SiwaNetwork/QuantumStick/README.md

# TimeStick 2

rev.2.1.1
- изготавливалась
- не завелся ethernet
- неправильные dip свичи

rev.2.1.2
- изменен RJ-45 разъем для прямой трассировки
- dip свич вынесен на край платы

rev.2.1.3
- добавлен отдельный трансформатор на ethernet
