SiwaNetwork/QuantumStick/TimeStick/ECAD/02_PTP_USB_TO_RJ45_DRC/Project Outputs for 02_PTP_USB_TO_RJ45_DRC/Report Board Stack/PCB1.xls

Board Stack Report
Stack Up |  | Layer Stack
Layer | Board Layer Stack | Name | Material | Thickness | Constant | Dk | Df
1 |  | Top Overlay |  | 0mil
2 |  | Top Solder | SM-001 | 1mil | 4 | 4 | 0.03
3 |  | Top Surface Finish | PbSn | 0.787mil
4 |  | Top Layer | CF-004 | 1.378mil
5 |  | Dielectric 1 | PP-017 | 8.284mil | 4.4 | 4.4 | 0.02
6 |  | Int1 (GND) | CF-004 | 0.598mil
7 |  | Dielectric 3 | Core-039 | 41.929mil | 4.6 | 4.6 | 0.02
8 |  | Int2 (PWR) | CF-004 | 0.598mil
9 |  | Dielectric 5 | PP-017 | 8.284mil | 4.4 | 4.4 | 0.02
10 |  | Bottom Layer | CF-004 | 1.378mil
11 |  | Bottom Surface Finish | PbSn | 0.787mil
12 |  | Bottom Solder | SM-001 | 1mil | 4 | 4 | 0.03
13 |  | Bottom Overlay |  | 0mil
 | Height : 66.024mil
