SiwaNetwork/QuantumStick/web_monitor/README.md

# QuantumStick Web Monitor

Современный веб-интерфейс для мониторинга устройства QuantumStick (TimeStick) в реальном времени.






## ✨ Особенности

- 🚀 **Современный интерфейс** - Адаптивный дизайн с темной темой
- 📊 **Графики в реальном времени** - Мониторинг PTP смещения и сетевого трафика
- 🔄 **WebSocket соединение** - Обновления данных без перезагрузки страницы
- 📱 **Мобильная поддержка** - Работает на всех устройствах
- 🎯 **Система алертов** - Уведомления о критических событиях
- 📈 **Детальная статистика** - Информация об устройстве, сети, PTP и системе
- 🛠 **Автоматическое обнаружение** - Поиск устройств TimeStick в системе

## 📋 Требования

### Системные требования
- Linux kernel 3.0+
- Python 3.8 или новее
- Права на чтение сетевых интерфейсов
- Установленные утилиты: `ethtool`, `ip`, `lsusb`

### Python зависимости
- Flask 2.3+
- Flask-SocketIO 5.3+
- python-socketio 5.8+
- eventlet 0.33+

## 🚀 Быстрый старт

### 1. Клонирование репозитория
```bash
git clone <repository-url>
cd QuantumStick/web_monitor
```

### 2. Автоматическая установка и запуск
```bash
chmod +x start_monitor.sh
./start_monitor.sh
```

### 3. Открыть веб-интерфейс
Откройте браузер и перейдите по адресу: http://localhost:8080

## 📖 Подробная установка

### Шаг 1: Установка системных зависимостей

#### Ubuntu/Debian:
```bash
sudo apt update
sudo apt install python3 python3-pip python3-venv ethtool iproute2 usbutils
```

#### CentOS/RHEL:
```bash
sudo yum install python3 python3-pip ethtool iproute usbutils
# или для новых версий:
sudo dnf install python3 python3-pip ethtool iproute usbutils
```

#### Arch Linux:
```bash
sudo pacman -S python python-pip ethtool iproute2 usbutils
```

### Шаг 2: Настройка окружения
```bash
# Создание виртуального окружения
python3 -m venv venv
source venv/bin/activate

# Установка Python зависимостей
pip install --upgrade pip
pip install -r requirements.txt
```

### Шаг 3: Проверка системы
```bash
# Проверка системных требований
./start_monitor.sh --check-only

# Поиск устройств TimeStick
lsusb | grep -i asix
```

## 🎮 Использование

### Запуск мониторинга

#### Автоматический запуск (рекомендуется):
```bash
./start_monitor.sh
```

#### Ручной запуск:
```bash
source venv/bin/activate
python3 app.py
```

#### Опции запуска:
```bash
./start_monitor.sh --help           # Показать справку
./start_monitor.sh --setup-only     # Только настройка окружения
./start_monitor.sh --check-only     # Только проверка системы
./start_monitor.sh --no-check       # Пропустить проверки
```

### Веб-интерфейс

После запуска откройте браузер и перейдите по адресу:
- **Локальный доступ**: http://localhost:8080
- **Сетевой доступ**: http://your-server-ip:8080

#### Основные функции:
1. **Запуск мониторинга** - Нажмите кнопку "Запустить мониторинг"
2. **Просмотр данных** - Данные обновляются автоматически каждую секунду
3. **Переключение графиков** - Выберите "PTP Смещение" или "Сетевой трафик"
4. **Просмотр алертов** - Уведомления отображаются в нижней части
5. **Остановка мониторинга** - Нажмите "Остановить мониторинг"

## 📊 Интерфейс и функции

### Карточки мониторинга

#### 🔧 Информация об устройстве
- Сетевой интерфейс
- Драйвер устройства
- Версия прошивки
- Скорость соединения
- Статус подключения

#### 🌐 Сетевая статистика
- Принятые/переданные пакеты
- Принятые/переданные байты
- Ошибки передачи
- Скорость передачи данных

#### ⏰ PTP Синхронизация
- Статус PTP
- Текущее смещение
- Счетчик синхронизации
- Время последней синхронизации
- Частотная коррекция

#### 💻 Системная информация
- Загрузка CPU (с прогресс-баром)
- Использование памяти (с прогресс-баром)
- Время работы системы
- Температура процессора

### 📈 Графики в реальном времени

#### PTP Смещение
- График смещения времени PTP в наносекундах
- Цветовая индикация: зеленый (хорошо), желтый (предупреждение), красный (ошибка)
- История последних 100 измерений

#### Сетевой трафик
- График пропускной способности в Mbps
- Суммарный RX + TX трафик
- Плавные анимации обновления

### 🚨 Система алертов

#### Типы уведомлений:
- **Ошибки** (красные): Критические проблемы, требующие внимания
- **Предупреждения** (желтые): Потенциальные проблемы
- **Информация** (зеленые): Нормальная работа системы

#### Условия алертов:
- Отключение устройства
- Большое PTP смещение (>10 мкс)
- Сетевые ошибки
- Высокая загрузка системы

## 🔧 Конфигурация

### Настройка портов
По умолчанию веб-сервер запускается на порту 8080. Для изменения отредактируйте файл `app.py`:

```python
if __name__ == '__main__':
    socketio.run(app, host='0.0.0.0', port=8080, debug=False)
```

### Настройка обновлений
Частота обновления данных (по умолчанию 1 секунда) настраивается в методе `monitor_loop()`:

```python
time.sleep(1)  # Обновление каждую секунду
```

### Настройка истории графиков
Количество точек на графиках (по умолчанию 100) настраивается в методе `update_history()`:

```python
max_history = 100  # Последние 100 точек
```

## 🛠 API

### REST Endpoints

#### GET /api/device_data
Получение всех данных устройства в формате JSON.

```json
{
  "device_info": {
    "interface": "eth0",
    "driver": "ax88179_178a",
    "version": "1.2.0",
    "connection_status": "Connected",
    "link_speed": 1000,
    "is_online": true
  },
  "ptp_status": { ... },
  "network_stats": { ... },
  "system_info": { ... },
  "alerts": [ ... ],
  "history": { ... }
}
```

#### POST /api/start_monitoring
Запуск мониторинга устройства.

Ответ:
```json
{
  "status": "success",
  "message": "Мониторинг запущен"
}
```

#### POST /api/stop_monitoring
Остановка мониторинга устройства.

### WebSocket Events

#### Подключение к серверу
```javascript
const socket = io();
```

#### Получение обновлений
```javascript
socket.on('device_update', function(data) {
    // Обработка данных устройства
    console.log(data);
});
```

#### Запрос данных
```javascript
socket.emit('request_data');
```

## 🔍 Диагностика и устранение неполадок

### Проверка устройства
```bash
# Проверка USB устройств ASIX
lsusb | grep -i asix

# Проверка сетевых интерфейсов
ip link show

# Проверка драйверов
for iface in $(ip link show | grep -o 'eth[0-9]*'); do
    echo "Interface: $iface"
    ethtool -i $iface | grep driver
done
```

### Логи и отладка
```bash
# Просмотр логов
tail -f logs/quantum_monitor_*.log

# Запуск с подробными логами
python3 app.py --debug
```

### Частые проблемы

#### Устройство не найдено
- Проверьте подключение USB
- Убедитесь, что драйвер загружен: `lsmod | grep ax88`
- Проверьте права доступа к устройству

#### Ошибки доступа к сети
- Запустите с правами администратора для доступа к ethtool
- Установите недостающие утилиты (ethtool, iproute2)

#### Проблемы с Python зависимостями
```bash
# Переустановка зависимостей
pip install --force-reinstall -r requirements.txt

# Проверка версий
pip list | grep -E "(flask|socketio)"
```

## 📁 Структура проекта

```
web_monitor/
├── app.py                 # Основное приложение Flask
├── start_monitor.sh       # Сценарий запуска
├── requirements.txt       # Python зависимости
├── README.md             # Документация
├── templates/
│   └── index.html        # Веб-интерфейс
├── logs/                 # Директория логов
├── venv/                 # Виртуальное окружение
└── static/               # Статические файлы (если нужны)
```

## 🔒 Безопасность

### Рекомендации
- Не запускайте веб-сервер с правами root в продакшене
- Используйте HTTPS для удаленного доступа
- Настройте firewall для ограничения доступа
- Регулярно обновляйте зависимости

### Настройка HTTPS (опционально)
```python
# В app.py для использования SSL
socketio.run(app, host='0.0.0.0', port=8443, 
             certfile='cert.pem', keyfile='key.pem')
```

## 🤝 Интеграция с существующими инструментами

### Интеграция с chrony
Данные PTP могут быть переданы в chrony для синхронизации времени:

```bash
# Пример конфигурации chrony
refclock PHC /dev/ptp0 poll 0 dpoll -2 offset 0
```

### Экспорт данных
Данные мониторинга можно экспортировать для анализа:

```python
# Сохранение статистики в CSV
import csv
with open('ptp_stats.csv', 'w') as f:
    writer = csv.writer(f)
    writer.writerow(['timestamp', 'offset_ns'])
    # Добавление данных...
```

## 📄 Лицензия

Проект распространяется под лицензией GPL v2, совместимой с основным драйвером TimeStick.

## 👥 Поддержка и вклад

### Сообщение об ошибках
При обнаружении ошибок создайте issue с подробным описанием:
- Версия ОС и ядра Linux
- Версия Python
- Логи ошибки
- Шаги для воспроизведения

### Запросы функций
Для предложения новых функций создайте feature request с описанием:
- Цель и назначение функции
- Примеры использования
- Возможная реализация

## 📞 Контакты

Для получения поддержки и дополнительной информации обращайтесь к документации основного проекта QuantumStick.

---

**QuantumStick Web Monitor** - современное решение для мониторинга высокоточных устройств синхронизации времени.
