SiwaNetwork/QuantumStick/TimeStick/README.md

# 1PPS USB
Это USB-ключ 3.2 Gen1 для гигабитного Ethernet, основанный на чипе AX88179B.
AX88179B поддерживает протокол точного времени (PTP) (IEEE 1588v2 и 802.1AS).
В данной аппаратной реализации используется разъем SMA типа "мама", который предназначен для вывода сигнала 1PPS от AX88179B.
Что это значит:
Ключ обеспечивает высокоскоростное подключение к сети Ethernet, а также включает в себя возможность точной синхронизации времени (с помощью PTP). Но самое главное - он позволяет получить доступ к сигналу 1PPS (Один импульс в секунду), который очень важен для приложений, где требуется точное время, например:
Точный хронометраж: для точного измерения и записи времени.
Научное оборудование: для точной синхронизации научных приборов.
Сети: для точной временной маркировки сетевых пакетов.
Вывод сигнала 1PPS:
Разъем SMA, включенный в этот USB-ключ, позволяет легко и удобно использовать сигнал 1PPS в различных проектах и системах, что делает его ценным инструментом для разработчиков и инженеров, работающих с приложениями, требующими точной синхронизации времени.
