SiwaNetwork/QuantumStick/REMOVAL_SUMMARY.md

# Удаление поддержки Windows - Сводка изменений

## Обзор
Полностью удалена вся поддержка Windows из проекта TimeStick. Теперь проект поддерживает только Linux платформу.

## Удаленные файлы и директории

### Windows Driver
- `windows_driver/` - Полностью удален весь каталог с драйвером для Windows
  - `windows_driver/src/timestick_windows.h` - Заголовочный файл API
  - `windows_driver/src/timestick_driver.c` - Основной код драйвера ядра  
  - `windows_driver/src/timestick_usermode.c` - Пользовательская библиотека
  - `windows_driver/inf/timestick.inf` - INF файл для установки драйвера
  - `windows_driver/build/Makefile` - Система сборки Windows
  - `windows_driver/install_timestick.ps1` - PowerShell скрипт установки
  - `windows_driver/README_WINDOWS.md` - Документация Windows драйвера

### Web Monitor
- `web_monitor/windows_support.py` - Модуль поддержки Windows (19,371 строк)

### Документация
- `WINDOWS_IMPLEMENTATION.md` - Полная документация реализации Windows (244 строки)

## Измененные файлы

### web_monitor/app.py
- Удалены импорты: `from windows_support import ...`
- Удалена переменная `WINDOWS_SUPPORT`
- Упрощена функция `create_monitor()` - только Linux поддержка
- Обновлены API endpoints:
  - `/api/platform` - удален флаг windows_support
  - `/api/devices/detect` - только Linux логика
  - `/api/network/interfaces` - только Linux логика  
  - `/api/driver/install` - возвращает ошибку "не поддерживается на Linux"

### web_monitor/templates/index.html
- Удален раздел "Windows поддержка" из UI
- Удалены кнопки "Поиск устройств" и "Установить драйвер"
- Удалены JavaScript функции:
  - `detectDevices()`
  - `showDriverInstall()`
  - `installDriver(packagePath)`
- Упрощена функция `loadPlatformInfo()`

### web_monitor/requirements.txt
- Удалены Windows-специфичные пакеты:
  - `pywin32==306; sys_platform == "win32"`
  - `wmi==1.5.1; sys_platform == "win32"`

## Удаленные Git ветки
- `cursor/windows-c4d5` - локальная ветка разработки Windows

## Статистика изменений
- **12 файлов изменено**
- **33 добавления, 2402 удаления**
- **Удалено ~20,000 строк Windows-специфичного кода**

## Результат
Проект теперь поддерживает **только Linux** платформу. Весь Windows-специфичный код, драйверы, документация и зависимости полностью удалены. Система стала значительно проще и сфокусирована на Linux окружении.
