SiwaNetwork/QuantumStick/QUANTUM_STICK_WEB_MONITOR.md

# QuantumStick Web Monitor - Обзор проекта

## 🎯 Что было создано

Я разработал современный веб-интерфейс для мониторинга устройства QuantumStick (TimeStick) с нуля, заменив консольные приложения на C современным веб-решением.

## ✨ Основные улучшения

### 🔄 Переход от консольного к веб-интерфейсу
- **Было**: Консольные программы `timestick_monitor.c` и `timestick_ptp_monitor.c` с ncurses
- **Стало**: Современный адаптивный веб-интерфейс с темной темой

### 📊 Визуализация данных
- **Было**: Текстовый вывод статистики
- **Стало**: Интерактивные графики в реальном времени с Chart.js

### 🔗 Архитектура
- **Было**: Прямая работа с IOCTL и системными вызовами
- **Стало**: Backend Flask + WebSocket для real-time обновлений

## 🏗️ Архитектура решения

```
┌─────────────────────────────────────────────────────────────┐
│                    Веб-браузер                              │
│   ┌─────────────┐  ┌─────────────┐  ┌─────────────┐        │
│   │   График    │  │  Карточки   │  │   Алерты    │        │
│   │     PTP     │  │ мониторинга │  │             │        │
│   └─────────────┘  └─────────────┘  └─────────────┘        │
└─────────────────────┬───────────────────────────────────────┘
                      │ WebSocket / HTTP
┌─────────────────────▼───────────────────────────────────────┐
│                Flask Backend (Python)                      │
│  ┌─────────────────────────────────────────────────────────┐│
│  │           TimeStickMonitor Class                       ││
│  │  • Обнаружение устройств                               ││
│  │  • Чтение данных через ethtool/ip                      ││
│  │  • Мониторинг PTP через /dev/ptp*                      ││
│  │  • Системная статистика                                ││
│  └─────────────────────────────────────────────────────────┘│
└─────────────────────┬───────────────────────────────────────┘
                      │ System calls
┌─────────────────────▼───────────────────────────────────────┐
│                  Linux System                              │
│  • ethtool (информация о драйвере)                         │
│  • /proc/net/dev (сетевая статистика)                      │
│  • /dev/ptp* (PTP устройства)                              │
│  • /proc/loadavg, /proc/meminfo (система)                  │
└─────────────────────────────────────────────────────────────┘
```

## 📂 Структура проекта

```
web_monitor/
├── 📄 app.py                 # Основное Flask приложение
├── 🎭 demo_mode.py           # Демо режим для тестирования
├── 🌐 templates/
│   └── index.html            # Современный веб-интерфейс
├── 🚀 start_monitor.sh       # Автоматический запуск
├── 🔧 Makefile               # Система сборки и управления
├── 📋 requirements.txt       # Python зависимости
├── 📖 README.md              # Полная документация
└── ⚡ QUICK_START.md         # Быстрый старт
```

## 🎨 Интерфейс

### Главный экран
- **Заголовок**: Логотип и индикатор подключения
- **Панель управления**: Кнопки запуска/остановки/обновления
- **Карточки мониторинга**: 4 основные секции
- **Графики**: Переключаемые диаграммы в реальном времени
- **Алерты**: Система уведомлений

### Карточки мониторинга

#### 🔧 Устройство
- Сетевой интерфейс
- Драйвер и версия
- Скорость соединения
- Статус подключения

#### 🌐 Сеть  
- RX/TX пакеты и байты
- Ошибки передачи
- Цветовая индикация проблем

#### ⏰ PTP Синхронизация
- Статус включения
- Текущее смещение
- Счетчик синхронизации
- Время последней синхронизации

#### 💻 Система
- CPU загрузка (с прогресс-баром)
- Память (с прогресс-баром)  
- Время работы
- Температура

### Графики реального времени
- **PTP Смещение**: График отклонений синхронизации
- **Сетевой трафик**: Пропускная способность
- **Переключение**: Вкладки для выбора типа графика
- **История**: Последние 100 измерений

## 🚀 Возможности

### Real-time мониторинг
- ⚡ Обновления каждую секунду
- 🔄 WebSocket соединение
- 📊 Анимированные графики
- 🎯 Автоматические алерты

### Адаптивность
- 📱 Мобильная поддержка
- 🌙 Темная тема
- 🎨 Современный дизайн
- ✨ Плавные анимации

### Система алертов
- 🔴 Критические ошибки
- 🟡 Предупреждения
- 🟢 Информационные сообщения
- 📅 Временные метки

## 🛠️ Установка и использование

### Быстрый старт (демо)
```bash
cd web_monitor
make demo
# Откройте http://localhost:8080
```

### С реальным устройством
```bash
cd web_monitor
make install
make run
# Откройте http://localhost:8080
```

### Системные требования
- Linux kernel 3.0+
- Python 3.8+
- ethtool, iproute2
- Браузер с поддержкой WebSocket

## 🎭 Демо режим

Для тестирования без реального устройства создан полнофункциональный демо режим:

- ✅ Имитация PTP смещений с реалистичными колебаниями
- ✅ Генерация сетевого трафика
- ✅ Системная нагрузка
- ✅ Случайные алерты
- ✅ Полная функциональность UI

## 🔧 Технический стек

### Backend
- **Flask** - веб-фреймворк
- **Flask-SocketIO** - WebSocket поддержка
- **Python 3.8+** - основной язык

### Frontend  
- **HTML5** - семантическая разметка
- **CSS3** - современные стили, анимации
- **JavaScript** - интерактивность
- **Chart.js** - графики
- **Socket.IO** - real-time обновления
- **Font Awesome** - иконки

### Система
- **ethtool** - информация о сетевых интерфейсах
- **iproute2** - управление сетью
- **/proc filesystem** - системная статистика
- **/dev/ptp*** - PTP устройства

## 🆚 Сравнение с оригиналом

| Аспект | Оригинал (C/ncurses) | Новый (Web) |
|---|---|---|
| **Интерфейс** | Консольный текст | Современный веб |
| **Доступность** | Только локально | Удаленный доступ |
| **Графики** | Нет | Интерактивные |
| **Мобильность** | Нет | Адаптивный |
| **Установка** | make/gcc | Python/pip |
| **Расширяемость** | Сложно | Легко |
| **Пользователи** | Один | Множество |

## 🎯 Преимущества

### Для пользователей
- 🌐 **Веб-доступ**: Мониторинг из любой точки сети
- 📱 **Мобильность**: Работа на телефонах и планшетах  
- 👁️ **Наглядность**: Графики вместо цифр
- 🔄 **Real-time**: Автоматические обновления

### Для разработчиков
- 🛠️ **Современность**: Актуальный технологический стек
- 🔧 **Расширяемость**: Простое добавление функций
- 🧪 **Тестирование**: Демо режим
- 📖 **Документация**: Подробные инструкции

### Для администраторов
- 🚀 **Простота**: Автоматическая установка
- 📊 **Мониторинг**: Централизованный контроль
- 🔍 **Диагностика**: Детальные логи
- 🎯 **Алерты**: Уведомления о проблемах

## 🚀 Возможности расширения

### Дополнительные функции
- 📈 **Экспорт данных** в CSV/JSON
- 📧 **Email уведомления** при критических событиях
- 🔐 **Аутентификация** для безопасного доступа
- 📊 **Дашборды** для множественных устройств
- 🔌 **API расширения** для интеграций

### Интеграции
- **Grafana** - расширенная аналитика
- **Prometheus** - метрики и мониторинг
- **chrony/ntpd** - интеграция с NTP серверами
- **SNMP** - стандартные протоколы мониторинга

## 📈 Результат

Создан современный, наглядный и функциональный веб-интерфейс для мониторинга QuantumStick, который:

✅ **Заменяет** устаревшие консольные программы  
✅ **Обеспечивает** удаленный доступ и мобильность  
✅ **Предоставляет** визуализацию в реальном времени  
✅ **Упрощает** установку и использование  
✅ **Расширяет** возможности мониторинга  

Система готова к использованию и может быть легко адаптирована под конкретные требования!
