SiwaNetwork/QuantumStick/TimeStick2/Archive/MFG_OUTPUTS/Report Board Stack/PCB1.xls

Board Stack Report
Stack Up |  | Layer Stack
Layer | Board Layer Stack | Name | Material | Thickness | Constant | Dk | Df
1 |  | Top Overlay |  | 0mm
2 |  | Top Solder | SM-001 | 0.0254mm | 4 | 4 | 0.03
3 |  | Top Surface Finish | PbSn | 0.02mm
4 |  | Top Layer | CF-004 | 0.035mm
5 |  | Dielectric 1 | PP-017 | 0.2104mm | 4.4 | 4.4 | 0.02
6 |  | Int1 (GND) | CF-004 | 0.0152mm
7 |  | Dielectric 3 | Core-039 | 1.065mm | 4.6 | 4.6 | 0.02
8 |  | Int2 (PWR) | CF-004 | 0.0152mm
9 |  | Dielectric 5 | PP-017 | 0.2104mm | 4.4 | 4.4 | 0.02
10 |  | Bottom Layer | CF-004 | 0.035mm
11 |  | Bottom Surface Finish | PbSn | 0.02mm
12 |  | Bottom Solder | SM-001 | 0.0254mm | 4 | 4 | 0.03
13 |  | Bottom Overlay |  | 0mm
 | Height : 1.677mm
