SiwaNetwork/QuantumStick/TimeStick2.1.2/ECAD/Project Outputs for TIMESTICK_2.1/TIMESTICK_2.1_rev.1.2_BOM 2025-04-30 12-16.xlsx

Designator | Comment | Description | Footprint | LibRef | Quantity | HelpURL | Value
C1, C2, C3, C4, C8, C9, C11, C12, C17, C20, C23, C24, C25, C26, C27, C28, C29, C31, C32, C33, C34, C36, C37, C38, C39, C41, C42, C43, C44 | 0.1 µF | CAP CER 0.1UF 10V X7R 0402 | CAP 0402_1005 | CC0402KRX7R6BB104 | 29 |  | 0.1 µF
C5 | 10000 pF | CAP CER 10000PF 50V X7R 0402 | CAP 0402_1005 | CC0402KRX7R9BB103 | 1 |  | 10000 pF
C6, C15 | 1000 pF/2kV | CAP CER 1000PF 2KV X7R 1206 | CAP 1206_3216 - 0.8MM | CC1206KKX7RDBB102 | 2 |  | 1000 pF/2kV
C7 | 47 pF | CAP CER 47PF 50V C0G/NPO 0402 | CAP 0402_1005 | CC0402KRNPO9BN470 | 1 |  | 47 pF
C10, C16 | 1 µF | CAP CER 1UF 10V X5R 0402 | CAP 0402_1005 | CC0402KRX5R6BB105 | 2 |  | 1 µF
C13, C14 | 15 pF | CAP CER 15PF 50V C0G/NPO 0402 | CAP 0402_1005 | CC0402KRNPO9BN150 | 2 |  | 15 pF
C18, C30 | 22 µF | CAP CER 22UF 10V X5R 0603 | CAP 0603_1608 | CC0603MRX5R6BB226 | 2 |  | 22 µF
C19, C21, C22, C35, C40 | 4.7 µF | CAP CER 4.7UF 10V X5R 0402 | CAP 0402_1005 | CC0402MRX5R6BB475 | 5 |  | 4.7 µF
D1, D2 | L-1154GT | LED, 3mm, Green | LED_3MM_GREEN | L-1154GT | 2
D3, D4, D5 | TPD2EUSB30 | TVS DIODE 3.6VWM 8VC SOT3 | SOT35P100X50-3N | TPD2EUSB30ADRTR | 3
FB1, FB2, FB3, FB4, FB5 | 80 Ohms @ 100 MHz | FERRITE BEAD 80 OHM 0402 1LN | FER 0402_1005 | BLM15PD800SN1D | 5 |  | 80 Ohms @ 100 MHz
IC1 | NEO-M9N-00B | Integrated Circuit | NEOM9N00B | NEO-M9N-00B | 1
IC2 | MAX-M10M-00B | Integrated Circuit | MAXM10M00B | MAX-M10M-00B | 1
J1, J2, J5 | RF2-49B-T-00-50-G-HDW | Connector | RF249BT0050GHDW | RF2-49B-T-00-50-G-HDW | 3
J3 | PBS-5 | Connector | PBS-5 | PBS-5 | 1
J4 | ARJM11B1-805-AB-EW2 | Connector | ARJM11B1805ABEW2 | ARJM11B1-805-AB-EW2 | 1
J6 | 1054500101 | CONN RCP USB3.1 TYPEC 24P SMD RA | Molex 1054500101 | 1054500101 | 1
L1 | 27 nH | FIXED IND 27NH 350MA 0.46OHM SMD | Murata LQG15 0402 | LQG15HS27NJ02D | 1 |  | 27 nH
L2, L3 | 3.3µH | FIXED IND 3.3UH 1.2A 100 MOHM | IND 1008_2520 | LQM2HPN3R3MG0L | 2 |  | 3.3µH
Q1 | DMG2302UKQ-7 | MOSFET BVDSS: 8V-24V SOT23 T&R 3 | DIODES SOT-23-3 | DMG2302UKQ-7 | 1
R1, R2, R4, R5, R31, R32, R34, R35, R36, R37, R38 | 4.7 kOhms | RES 4.7K OHM 1% 1/16W 0402 | YAGEO RES 0402_1005 | RC0402FR-074k7L | 11 |  | 4.7 kOhms
R6, R7, R19, R40 | 10 kOhms | RES 10K OHM 1% 1/16W 0402 | YAGEO RES 0402_1005 | RC0402FR-0710KL | 4 |  | 10 kOhms
R8, R10 | 330 Ohms | RES 330 OHM 1% 1/16W 0402 | YAGEO RES 0402_1005 | RC0402FR-07330RL | 2 |  | 330 Ohms
R11, R13, R14, R16, R23, R26, R28 | 0 Ohms | RES 0 OHM JUMPER 1/16W 0402 | YAGEO RES 0402_1005 | RC0402FR-070RL | 7 |  | 0 Ohms
R12 | 10 Ohms | RES 10 OHM 1% 1/10W 0603 | YAGEO RES 0603_1608 | RC0603FR-0710RL | 1 |  | 10 Ohms
R15, R33 | 1 MOhms | RES 1M OHM 1% 1/16W 0402 | YAGEO RES 0402_1005 | RC0402FR-071ML | 2 |  | 1 MOhms
R17 | 49.9 kOhms | RES 49.9K OHM 1% 1/16W 0402 | YAGEO RES 0402_1005 | RC0402FR-0749K9L | 1 |  | 49.9 kOhms
R18 | 100 kOhms | RES 100K OHM 1% 1/16W 0402 | YAGEO RES 0402_1005 | RC0402FR-07100KL | 1 |  | 100 kOhms
R21 | 24 kOhms | RES 24K OHM 1% 1/16W 0402 | YAGEO RES 0402_1005 | RC0402FR-0724KL | 1 |  | 24 kOhms
R22, R24, R25 | 47 kOhms | RES 47K OHM 1% 1/16W 0402 | YAGEO RES 0402_1005 | RC0402FR-0747KL | 3 |  | 47 kOhms
R27 | 200 Ohms | RES 200 OHM 1% 1/16W 0402 | YAGEO RES 0402_1005 | RC0402FR-07200RL | 1 |  | 200 Ohms
R29, R30 | 5.1 kOhms | RES 5.1K OHM 1% 1/16W 0402 | YAGEO RES 0402_1005 | RC0402FR-075k1L | 2 |  | 5.1 kOhms
R39 | 22 Ohms | RES 22 OHM 1% 1/16W 0402 | YAGEO RES 0402_1005 | RC0402FR-0722RL | 1 |  | 22 Ohms
R41 | 39.2 kOhms | RES 39.2K OHM 1% 1/16W 0402 | YAGEO RES 0402_1005 | RC0402FR-0739K2L | 1 |  | 39.2 kOhms
S1 | DA-02RP | DIP Switch, 2P | DA02RP | DA-02RP | 1
U1, U3 | NC7WZ125K8X | Integrated Circuit | SOP50P310X90-8N | NC7WZ125K8X | 2
U2, U4 | SN74LVC1G3157DBVR | Integrated Circuit | SOT95P280X145-6N | SN74LVC1G3157DBVR | 2
U5 | AX88279 |  | IC_AX88279 | IC_AX88279 | 1
U6 | ST1S06PU33R | Synchronous rectification with inhibit, 1.5 A, 1.5 MHz adjustable, step-down switching regulator, 6-Pin DFN | DFN6D_L | CMP-0240-00158-1 | 1
U7 | SST25VF016B-50-4I-QAF-T | SST25VF016B-50-4I-QAF-T Flash Serial-SPI 3.3V 16Mbit 2M x 8bit 8ns 8-Pin WSON EP T/R - Tape and Reel | FP-C04-452-MFG | CMP-00252-18686437-1 | 1
U8 | ST1S06PUR | Synchronous rectification with inhibit, 1.5 A, 1.5 MHz adjustable, step-down switching regulator, 6-Pin DFN | DFN6D_M | CMP-0240-00159-1 | 1
Y1 | 25 MHz | CRYSTAL 25.0000MHZ 8PF SMD | NDK NX3225GA | NX3225GA-25.000M-STD-CRG-2 | 1 |  | 25 MHz
