SiwaNetwork/QuantumStick/TimeStick2/ECAD/Project Outputs for TIMESTICK_2/TIMESTICK_2_rev.1.1_release BOM 2025-02-25 10-48.xlsx

Designator | Comment | Description | Footprint | LibRef | Quantity | HelpURL | Value
C1, C2, C3, C4, C5, C6, C7, C8, C10, C11, C17, C19, C23, C24, C25, C26, C27, C28, C30, C31, C32, C33, C36, C37, C38, C39, C40, C41, C42, C43, C44 | 0.1 µF | CAP CER 0.1UF 10V X7R 0402 | CAP 0402_1005 | CC0402KRX7R6BB104 | 31 |  | 0.1 µF
C9, C15 | 1000 pF/2kV | CAP CER 1000PF 2KV X7R 1206 | CAP 1206_3216 - 0.8MM | CC1206KKX7RDBB102 | 2 |  | 1000 pF/2kV
C12 | 47 pF | CAP CER 47PF 50V C0G/NPO 0402 | CAP 0402_1005 | CC0402KRNPO9BN470 | 1 |  | 47 pF
C13, C14 | 15 pF | CAP CER 15PF 50V C0G/NPO 0402 | CAP 0402_1005 | CC0402KRNPO9BN150 | 2 |  | 15 pF
C16 | 1 µF | CAP CER 1UF 10V X5R 0402 | CAP 0402_1005 | CC0402KRX5R6BB105 | 1 |  | 1 µF
C18, C34 | 22 µF | CAP CER 22UF 10V X5R 0603 | CAP 0603_1608 | CC0603MRX5R6BB226 | 2 |  | 22 µF
C20, C21, C22, C29, C35 | 4.7 µF | CAP CER 4.7UF 10V X5R 0402 | CAP 0402_1005 | CC0402MRX5R6BB475 | 5 |  | 4.7 µF
D1, D2 | APT1608ZGCK | LED GREEN CLEAR CHIP SMD | FP-APT1608ZGCK-MFG | CMP-44529-000024-1 | 2
FB1, FB2, FB3, FB4, FB5 | 80 Ohms @ 100 MHz | FERRITE BEAD 80 OHM 0402 1LN | FER 0402_1005 | BLM15PD800SN1D | 5 |  | 80 Ohms @ 100 MHz
IC1 | MAX-F10S-00B | Integrated Circuit | MAXF10S00B | MAX-F10S-00B | 1
J1, J2 | 73100-0114 | Connector | 731000114 | 73100-0114 | 2
J3 | PBS-5 | Connector | PBS-5 | PBS-5 | 1
J4 | ARJM11D7-809-AB-EW2 | Connector | ARJM11D7809ABEW2 | ARJM11D7-809-AB-EW2 | 1
J5 | 1054500101 | CONN RCP USB3.1 TYPEC 24P SMD RA | Molex 1054500101 | 1054500101 | 1
L1, L2 | 3.3µH | FIXED IND 3.3UH 1.2A 100 MOHM | IND 1008_2520 | LQM2HPN3R3MG0L | 2 |  | 3.3µH
R1, R2, R8, R9, R18, R19, R32, R33, R34, R35 | 4.7 kOhms | RES 4.7K OHM 1% 1/16W 0402 | YAGEO RES 0402_1005 | RC0402FR-074k7L | 10 |  | 4.7 kOhms
R3, R4, R5, R6, R16, R37 | 10 kOhms | RES 10K OHM 1% 1/16W 0402 | YAGEO RES 0402_1005 | RC0402FR-0710KL | 6 |  | 10 kOhms
R10, R12 | 330 Ohms | RES 330 OHM 1% 1/16W 0402 | YAGEO RES 0402_1005 | RC0402FR-07330RL | 2 |  | 330 Ohms
R13, R30 | 1 MOhms | RES 1M OHM 1% 1/16W 0402 | YAGEO RES 0402_1005 | RC0402FR-071ML | 2 |  | 1 MOhms
R14 | 49.9 kOhms | RES 49.9K OHM 1% 1/16W 0402 | YAGEO RES 0402_1005 | RC0402FR-0749K9L | 1 |  | 49.9 kOhms
R17 | 100 kOhms | RES 100K OHM 1% 1/16W 0402 | YAGEO RES 0402_1005 | RC0402FR-07100KL | 1 |  | 100 kOhms
R20 | 33 Ohms | RES 33 OHM 1% 1/16W 0402 | YAGEO RES 0402_1005 | RC0402FR-0733RL | 1 |  | 33 Ohms
R21 | 24 kOhms | RES 24K OHM 1% 1/16W 0402 | YAGEO RES 0402_1005 | RC0402FR-0724KL | 1 |  | 24 kOhms
R22, R24, R25 | 47 kOhms | RES 47K OHM 1% 1/16W 0402 | YAGEO RES 0402_1005 | RC0402FR-0747KL | 3 |  | 47 kOhms
R23, R26, R27 | 0 Ohms | RES 0 OHM JUMPER 1/16W 0402 | YAGEO RES 0402_1005 | RC0402FR-070RL | 3 |  | 0 Ohms
R28 | 200 Ohms | RES 200 OHM 1% 1/16W 0402 | YAGEO RES 0402_1005 | RC0402FR-07200RL | 1 |  | 200 Ohms
R29, R31 | 5.1 kOhms | RES 5.1K OHM 1% 1/16W 0402 | YAGEO RES 0402_1005 | RC0402FR-075k1L | 2 |  | 5.1 kOhms
R36 | 22 Ohms | RES 22 OHM 1% 1/16W 0402 | YAGEO RES 0402_1005 | RC0402FR-0722RL | 1 |  | 22 Ohms
R38 | 39.2 kOhms | RES 39.2K OHM 1% 1/16W 0402 | YAGEO RES 0402_1005 | RC0402FR-0739K2L | 1 |  | 39.2 kOhms
SW1 | 218-4LPST | SWITCH SLIDE DIP SPST 25MA 24V | CTS 218-4LPJ | 218-4LPST | 1
U1, U4 | NC7WZ125K8X | Integrated Circuit | SOP50P310X90-8N | NC7WZ125K8X | 2
U2, U3, U5, U6 | SN74LVC1G3157DBVR | Integrated Circuit | SOT95P280X145-6N | SN74LVC1G3157DBVR | 4
U7 | AX88279 |  | IC_AX88279 | IC_AX88279 | 1
U8 | ESD7016MUTAG | Low Capacitance ESD Protection USB 3.0, 8-Pin UDFN, Pb-Free, Tape and Reel | ONSC-UDFN-8-517CB_V | CMP-1063-00263-1 | 1
U9 | ST1S06PU33R | Synchronous rectification with inhibit, 1.5 A, 1.5 MHz adjustable, step-down switching regulator, 6-Pin DFN | DFN6D_L | CMP-0240-00158-1 | 1
U10 | SST25VF016B-50-4I-QAF-T | SST25VF016B-50-4I-QAF-T Flash Serial-SPI 3.3V 16Mbit 2M x 8bit 8ns 8-Pin WSON EP T/R - Tape and Reel | FP-C04-452-MFG | CMP-00252-18686437-1 | 1
U11 | ST1S06PUR | Synchronous rectification with inhibit, 1.5 A, 1.5 MHz adjustable, step-down switching regulator, 6-Pin DFN | DFN6D_M | CMP-0240-00159-1 | 1
Y1 | 25 MHz | CRYSTAL 25.0000MHZ 8PF SMD | NDK NX3225GA | NX3225GA-25.000M-STD-CRG-2 | 1 |  | 25 MHz
