SiwaNetwork/QuantumStick/TimeStick2.1.2/ECAD/TIMESTICK_2.SLDASM

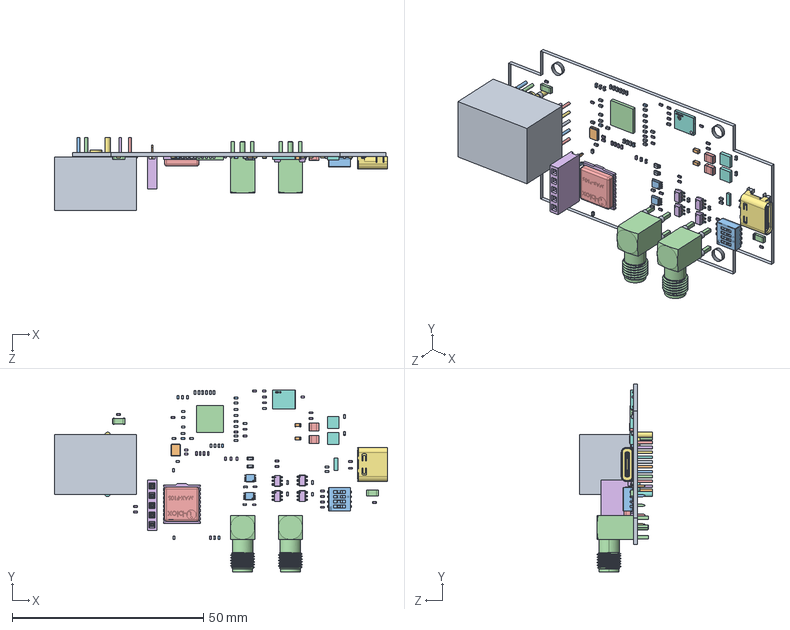
[picture p7: CAD file, 2025-07-18]
TimeStick2.1.2/ECAD/TIMESTICK_2.SLDASM
87.2 x 49.1 x 19.1 mm
0402 cap x 40
0603 cap x 2
FER 0402 x 5
7864657856-Part-2 x 2
INDUC 1008 x 2
0402 resistor x 35
0402 resistor-1 x 35
Extruded x 2
logo x 2
logo-1 x 2
logo-2 x 2
logo-3 x 2
logo-4 x 2
logo-5 x 2
logo-6 x 2
logo-7 x 2
logo-8 x 2
logo-9 x 2
logo-10 x 2
logo-11 x 2
cathode mark x 2
cathode mark-1 x 2
terminals x 2
terminals-1 x 2
lens x 2
base x 2
PinsArrayLR x 2
PinsArrayLR-1 x 2
PinsArrayLR-2 x 2
PinsArrayLR-3 x 2
PinsArrayLR-4 x 2
PinsArrayLR-5 x 2
PinsArrayLR-6 x 2
PinsArrayLR-7 x 2
Extruded-1
microchip
microchip-1
microchip-2
microchip-3
microchip-4
microchip-5
microchip-6
microchip-7
microchip-8
Microchip logo
circle
User Library-PBS_(DS1023)_1line_connectors_h=5_0_8_5mm_step_2_54mm (3)
User Library-PBS_(DS1023)_1line_connectors_h=5_0_8_5mm_step_2_54mm (3)-1
User Library-PBS_(DS1023)_1line_connectors_h=5_0_8_5mm_step_2_54mm (3)-2
User Library-PBS_(DS1023)_1line_connectors_h=5_0_8_5mm_step_2_54mm (3)-3
User Library-PBS_(DS1023)_1line_connectors_h=5_0_8_5mm_step_2_54mm (3)-4
User Library-PBS_(DS1023)_1line_connectors_h=5_0_8_5mm_step_2_54mm (3)-5
PinsArrayLR-8 x 4
PinsArrayLR-9 x 4
PinsArrayLR-10 x 4
PinsArrayLR-11 x 4
PinsArrayLR-12 x 4
PinsArrayLR-13 x 4
Leads
Leads-1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
