SiwaNetwork/QuantumStick/TimeStick/TimeStick.PDF

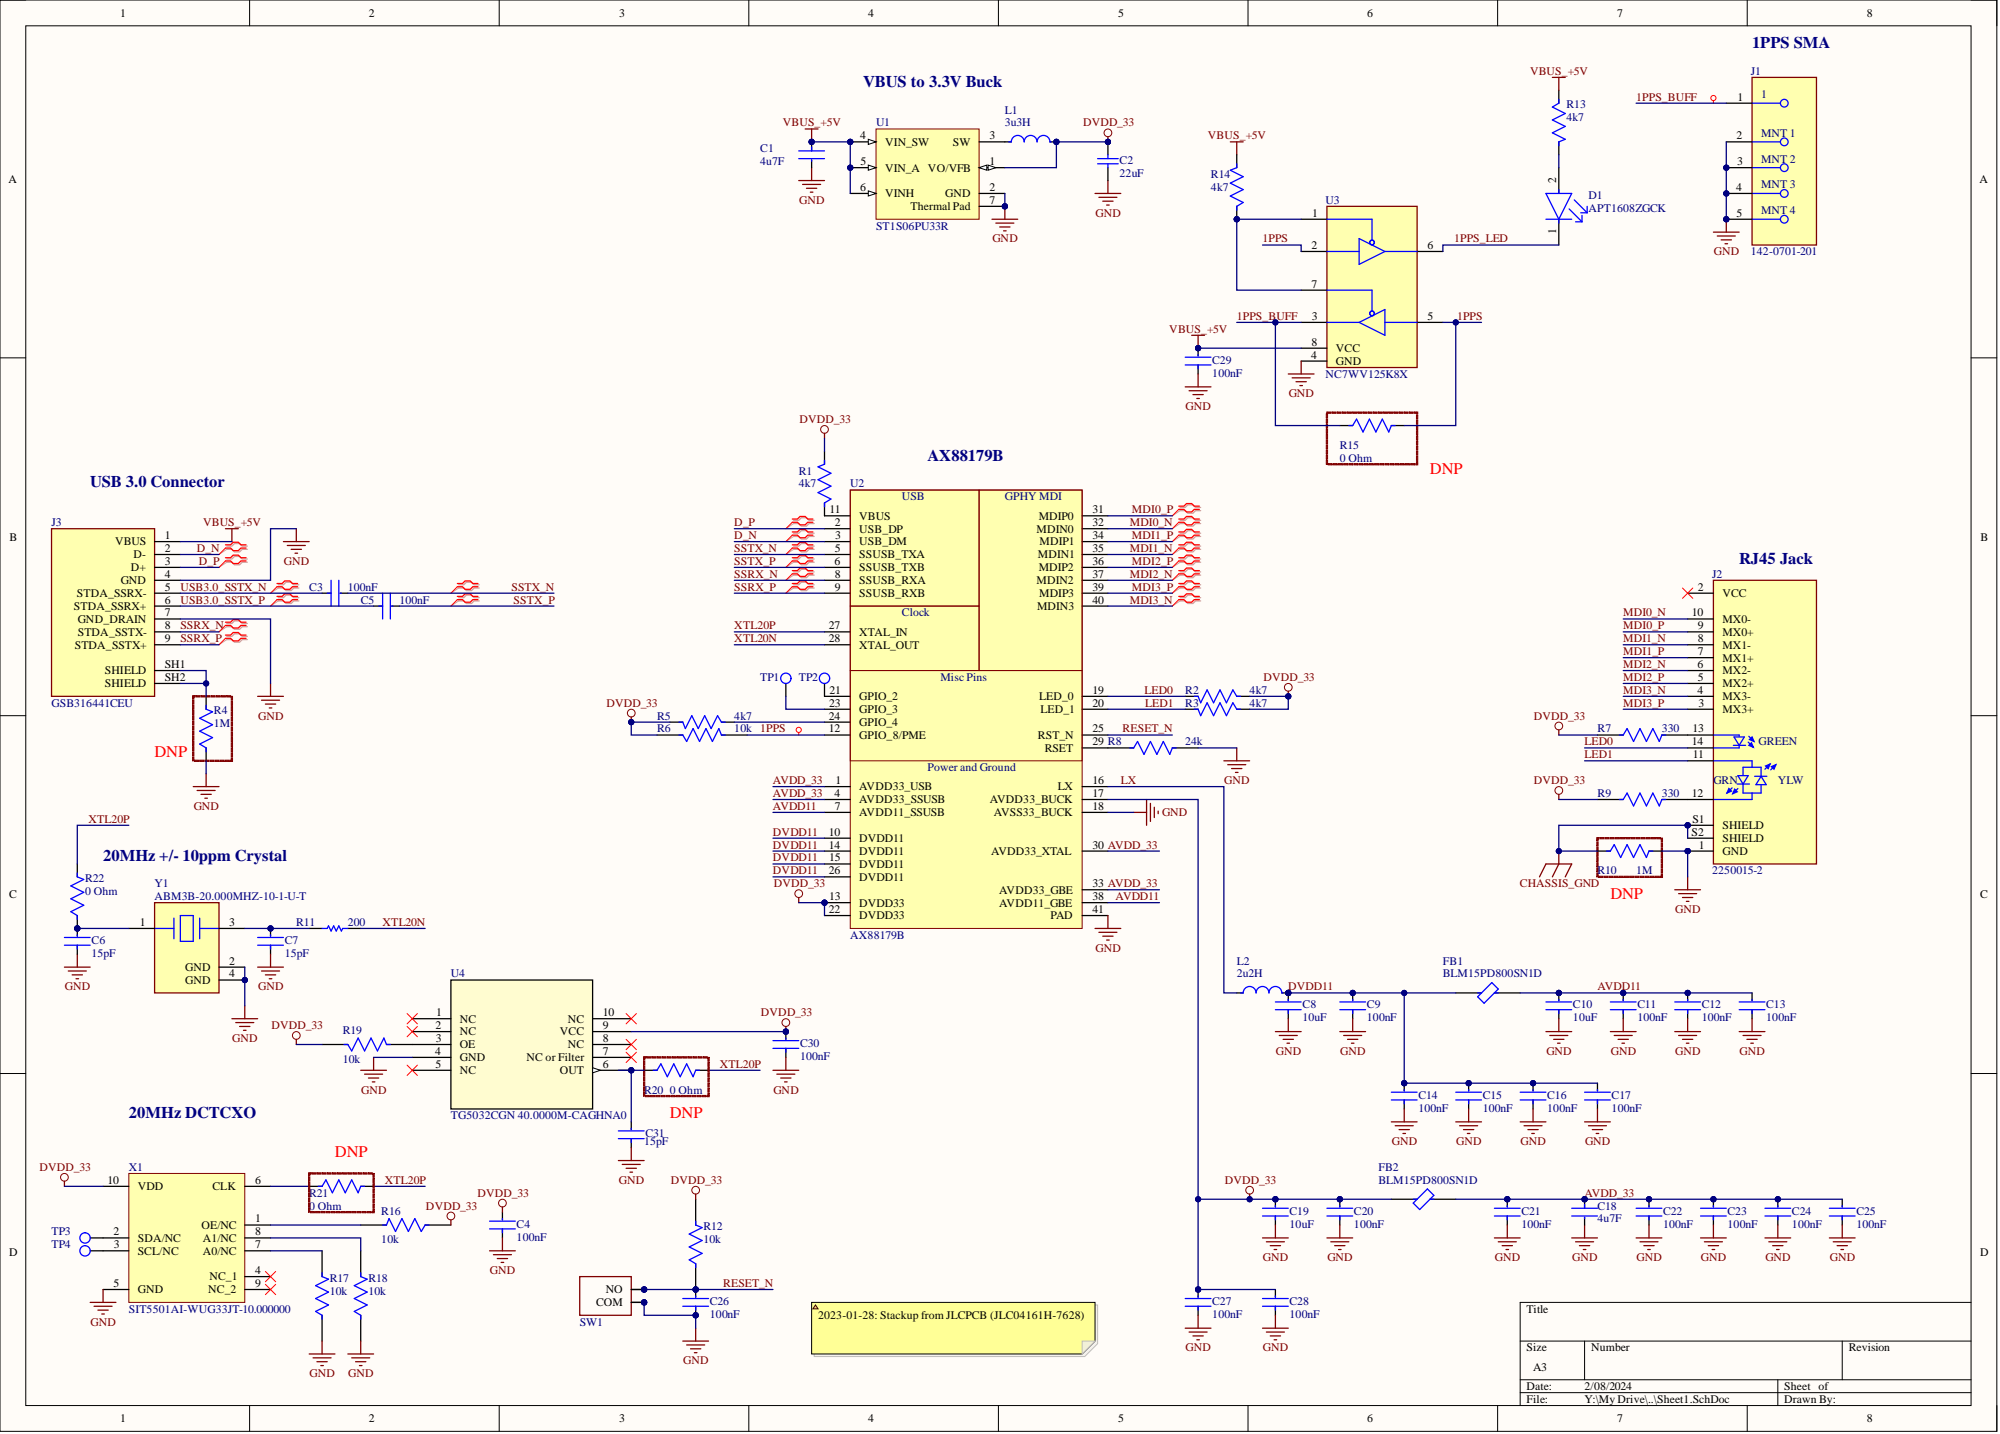
[picture p8: page 1]

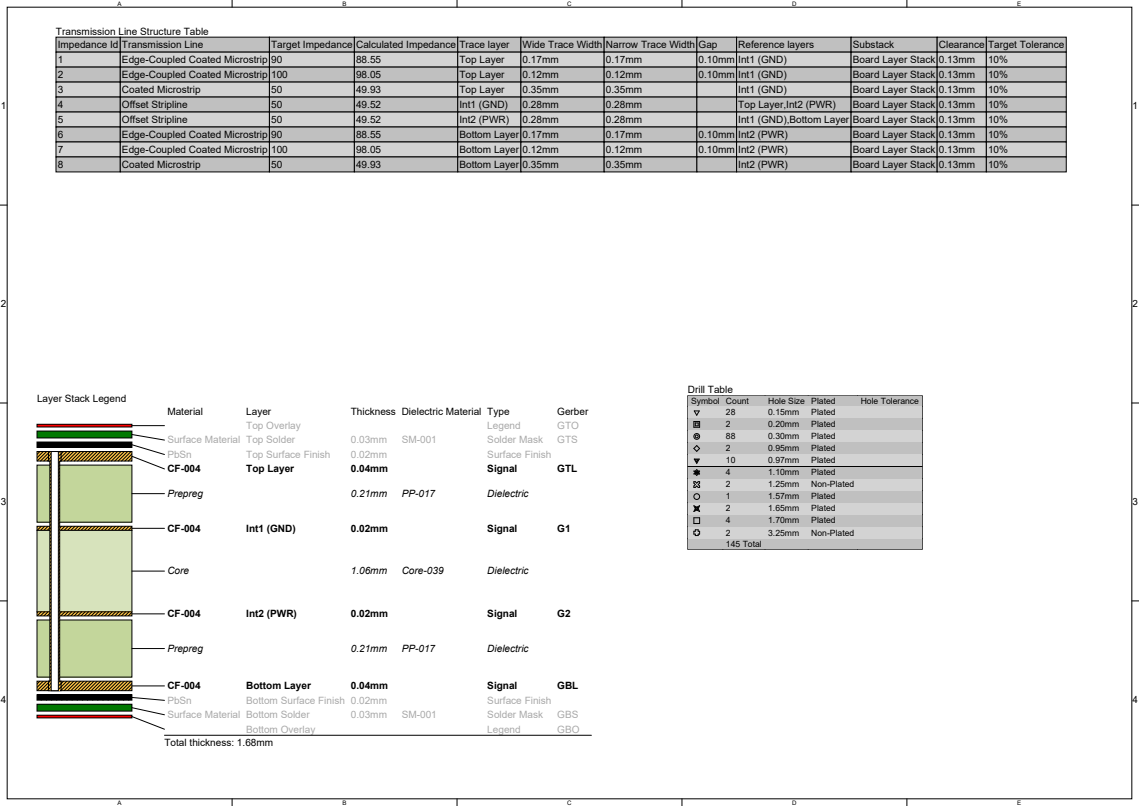
[picture p9: page 2]

Transmission Line Structure Table

Impedance Id | Transmission Line | Target Impedance | Calculated Impedance | Trace layer | Wide Trace Width | Narrow Trace Width | Gap | Reference layers | Substack | Clearance | Target Tolerance
1 | Edge-Coupled Coated Microstrip | 90 | 88.55 | Top Layer | 0.17mm | 0.17mm | 0.10mm | Int1 (GND) | Board Layer Stack | 0.13mm | 10%
2 | Edge-Coupled Coated Microstrip | 100 | 98.05 | Top Layer | 0.12mm | 0.12mm | 0.10mm | Int1 (GND) | Board Layer Stack | 0.13mm | 10%
3 | Coated Microstrip | 50 | 49.93 | Top Layer | 0.35mm | 0.35mm | | Int1 (GND) | Board Layer Stack | 0.13mm | 10%
4 | Offset Stripline | 50 | 49.52 | Int1 (GND) | 0.28mm | 0.28mm | | Top Layer,Int2 (PWR) | Board Layer Stack | 0.13mm | 10%
5 | Offset Stripline | 50 | 49.52 | Int2 (PWR) | 0.28mm | 0.28mm | | Int1 (GND),Bottom Layer | Board Layer Stack | 0.13mm | 10%
6 | Edge-Coupled Coated Microstrip | 90 | 88.55 | Bottom Layer | 0.17mm | 0.17mm | 0.10mm | Int2 (PWR) | Board Layer Stack | 0.13mm | 10%
7 | Edge-Coupled Coated Microstrip | 100 | 98.05 | Bottom Layer | 0.12mm | 0.12mm | 0.10mm | Int2 (PWR) | Board Layer Stack | 0.13mm | 10%
8 | Coated Microstrip | 50 | 49.93 | Bottom Layer | 0.35mm | 0.35mm | | Int2 (PWR) | Board Layer Stack | 0.13mm | 10%

Hole Size | Plated | Hole Tolerance

28 | 0.15mm | Plated
2 | 0.20mm | Plated
88 | 0.30mm | Plated
2 | 0.95mm | Plated
10 | 0.97mm | Plated
4 | 1.10mm | Plated
2 | 1.25mm | Non-Plated
1 | 1.57mm | Plated
2 | 1.65mm | Plated
4 | 1.70mm | Plated
2 | 3.25mm | Non-Plated
145 Total
