SiwaNetwork/QuantumStick/TimeStick2/TIMESTICK_2_rev.1.1_ SCH 2025-04-16 13-36.PDF

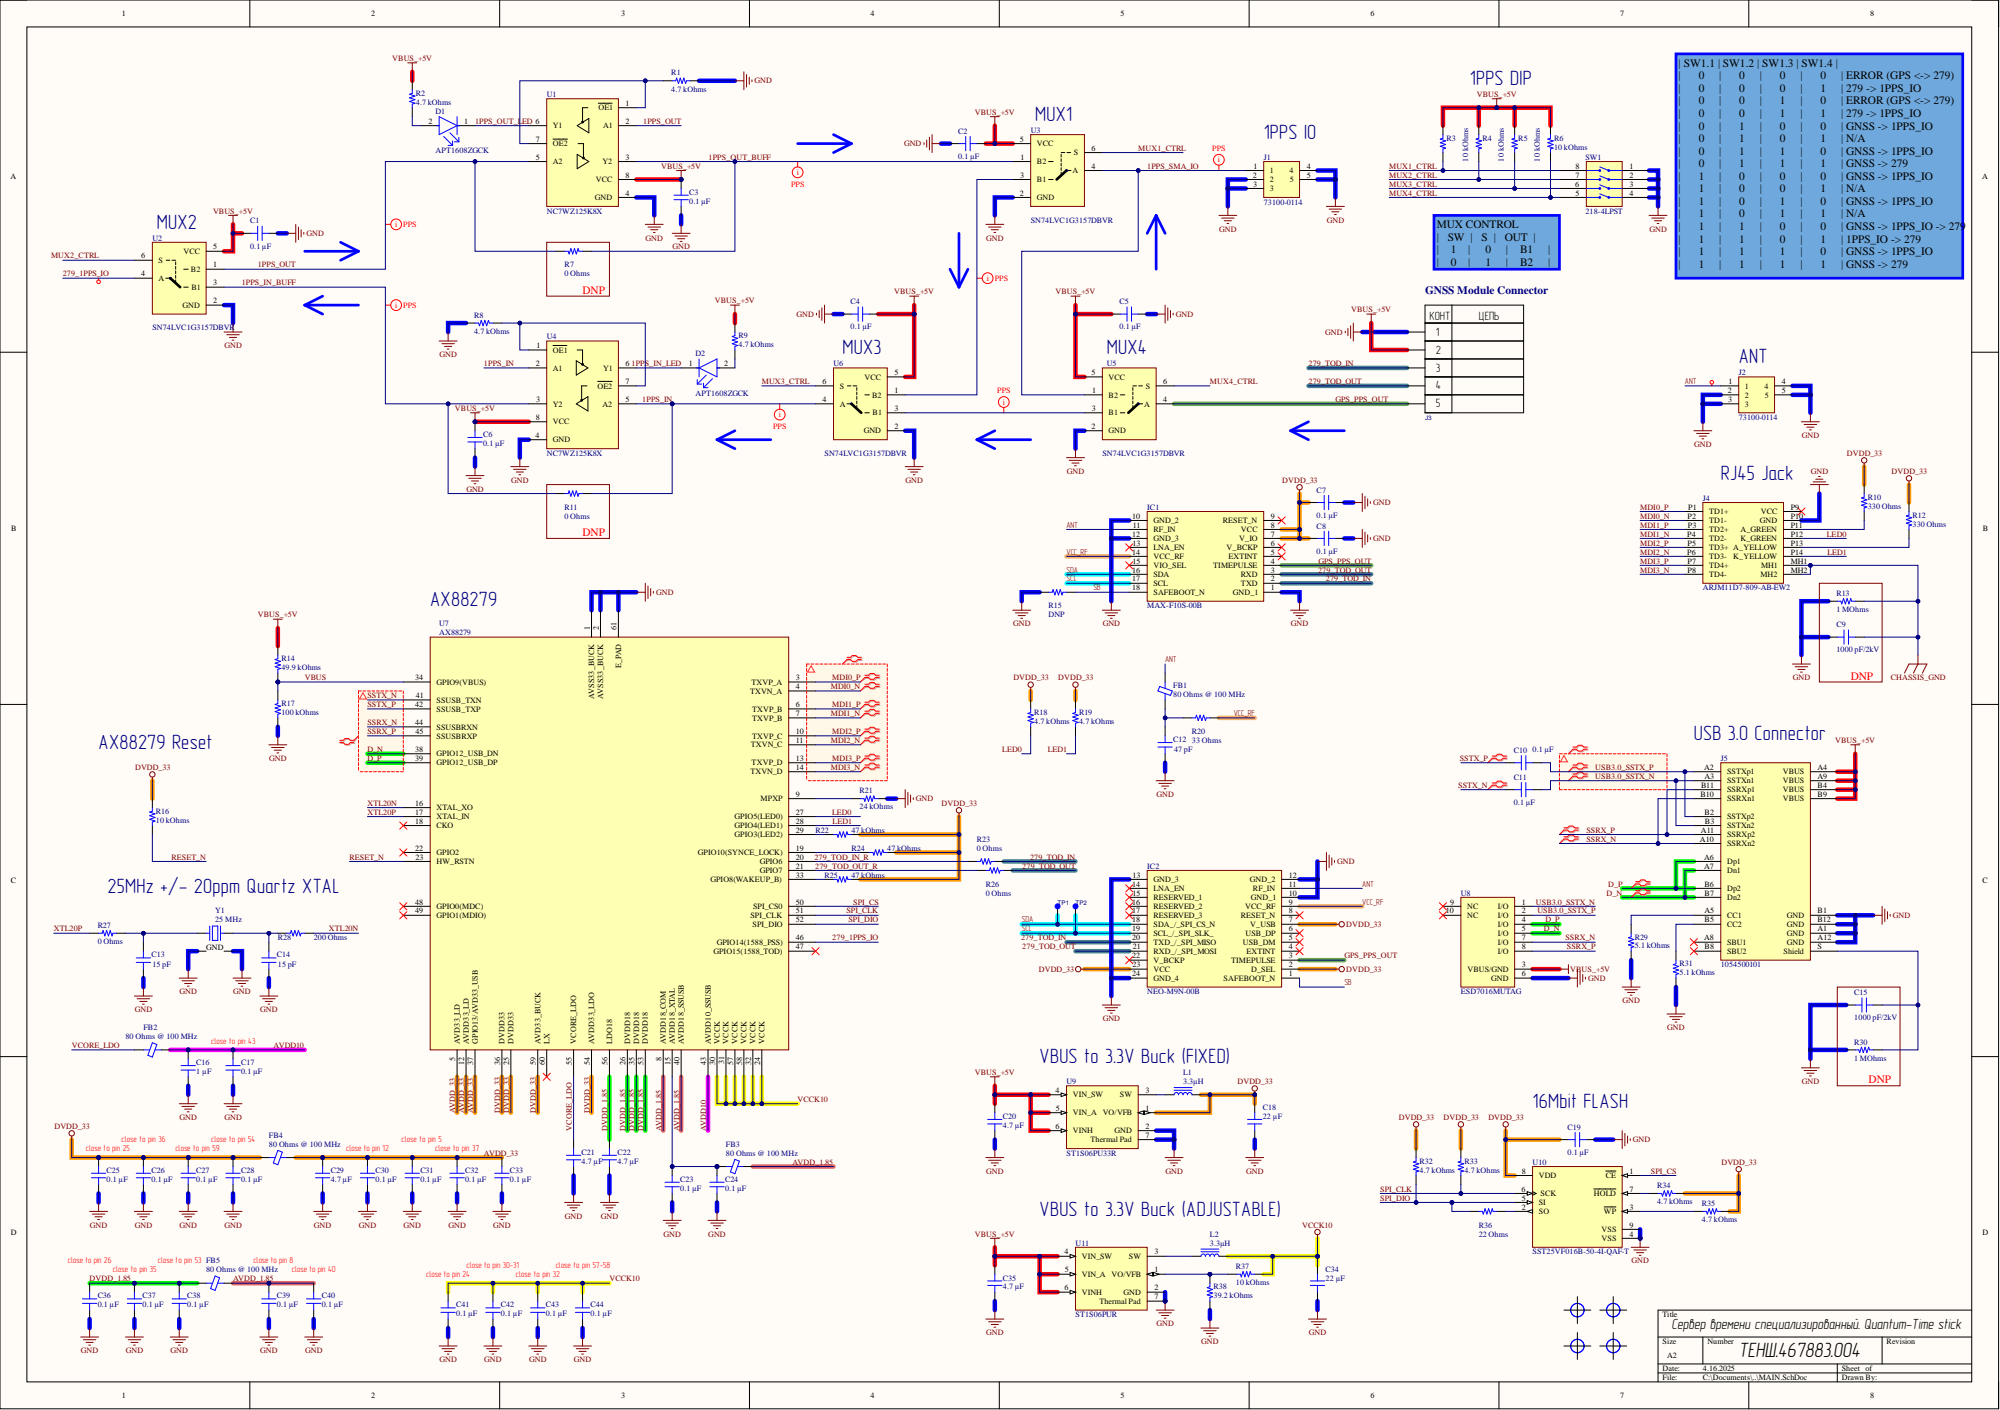
[picture p10: page 1]

TXD_/_SPI_MISO 20

V_BCKP 22

VBUS to 3.3V Buck (FIXED)

DNP

GND
VBUS to 3.3V Buck (ADJUSTABLE)

Title
Сервер времени специализированный. Quantum-Time stick
