SiwaNetwork/QuantumStick/TimeStick2.1.2/ECAD/Output/TIMESTICK_2.1_release ASSEMBLY 2025-04-30 12-15.PDF

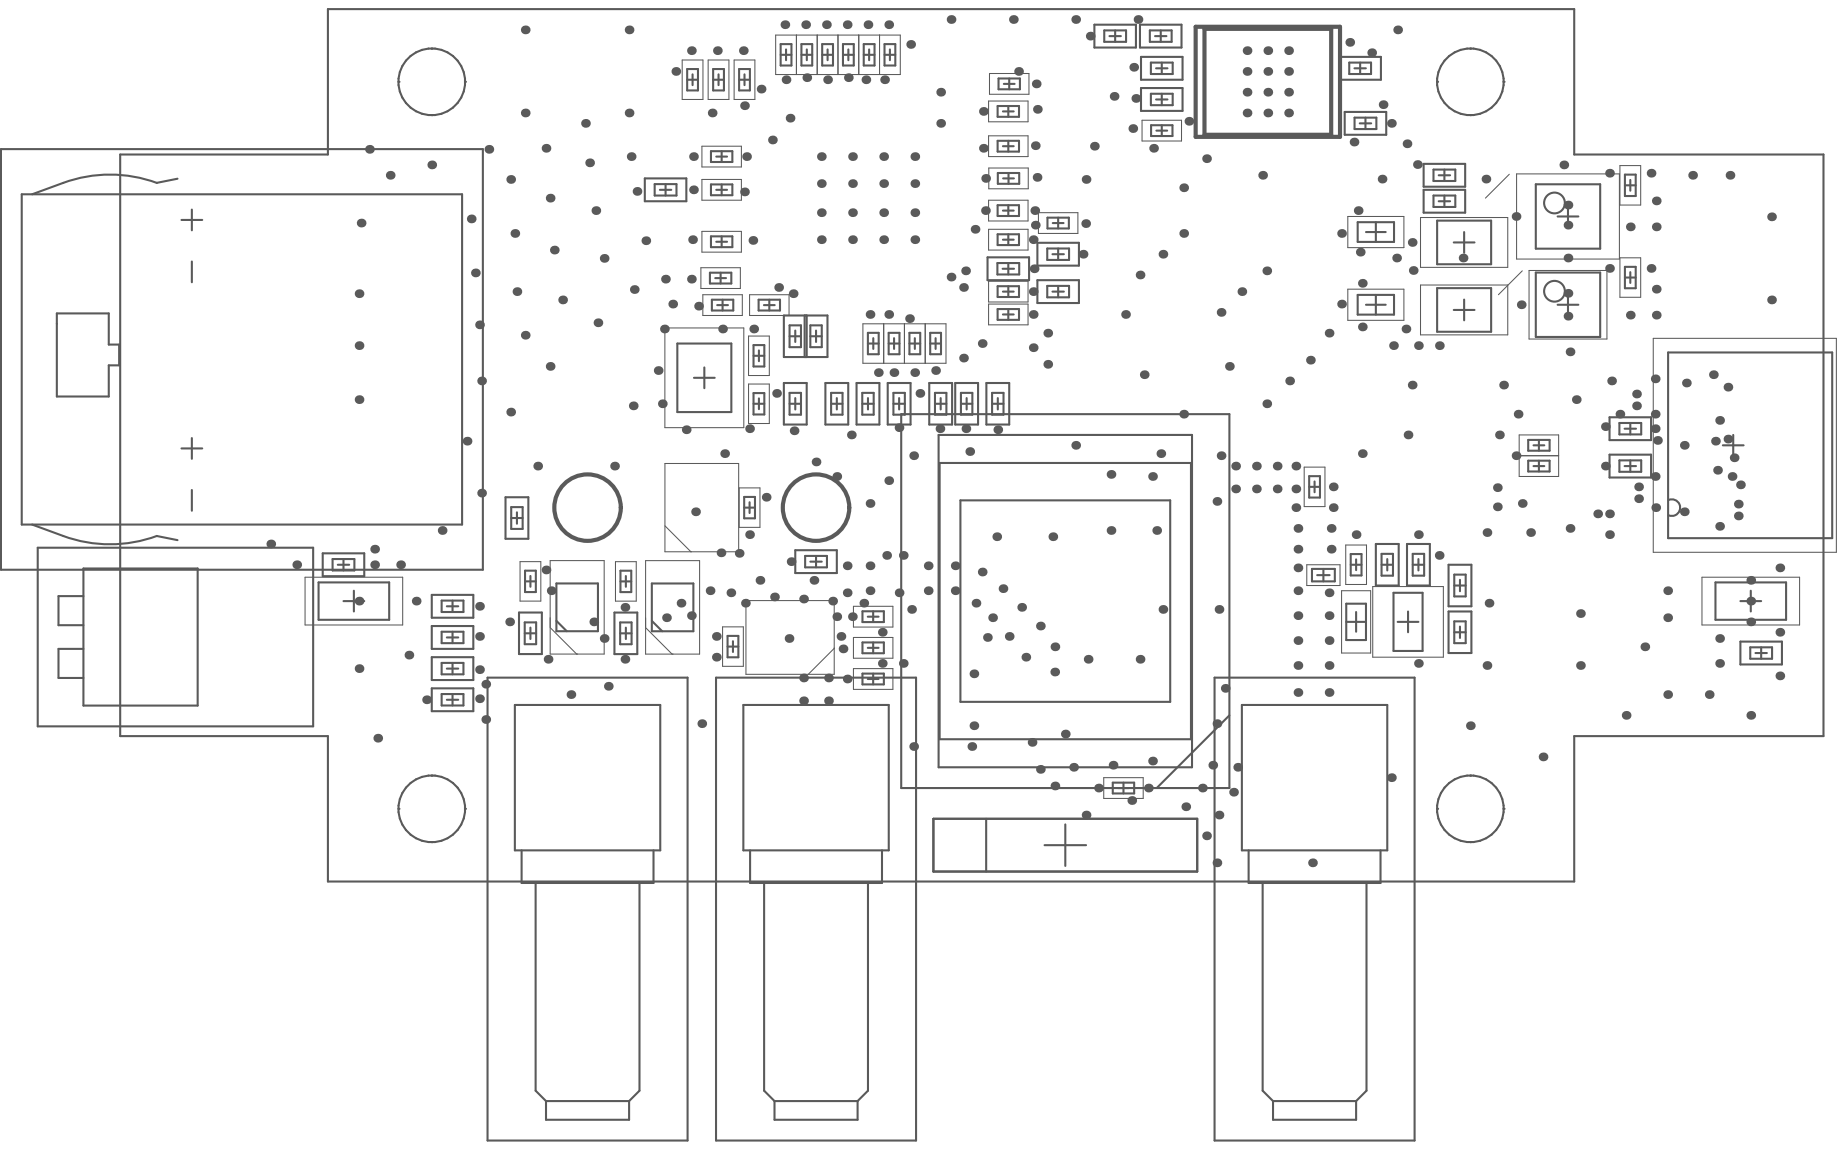
[picture p11: page 1]

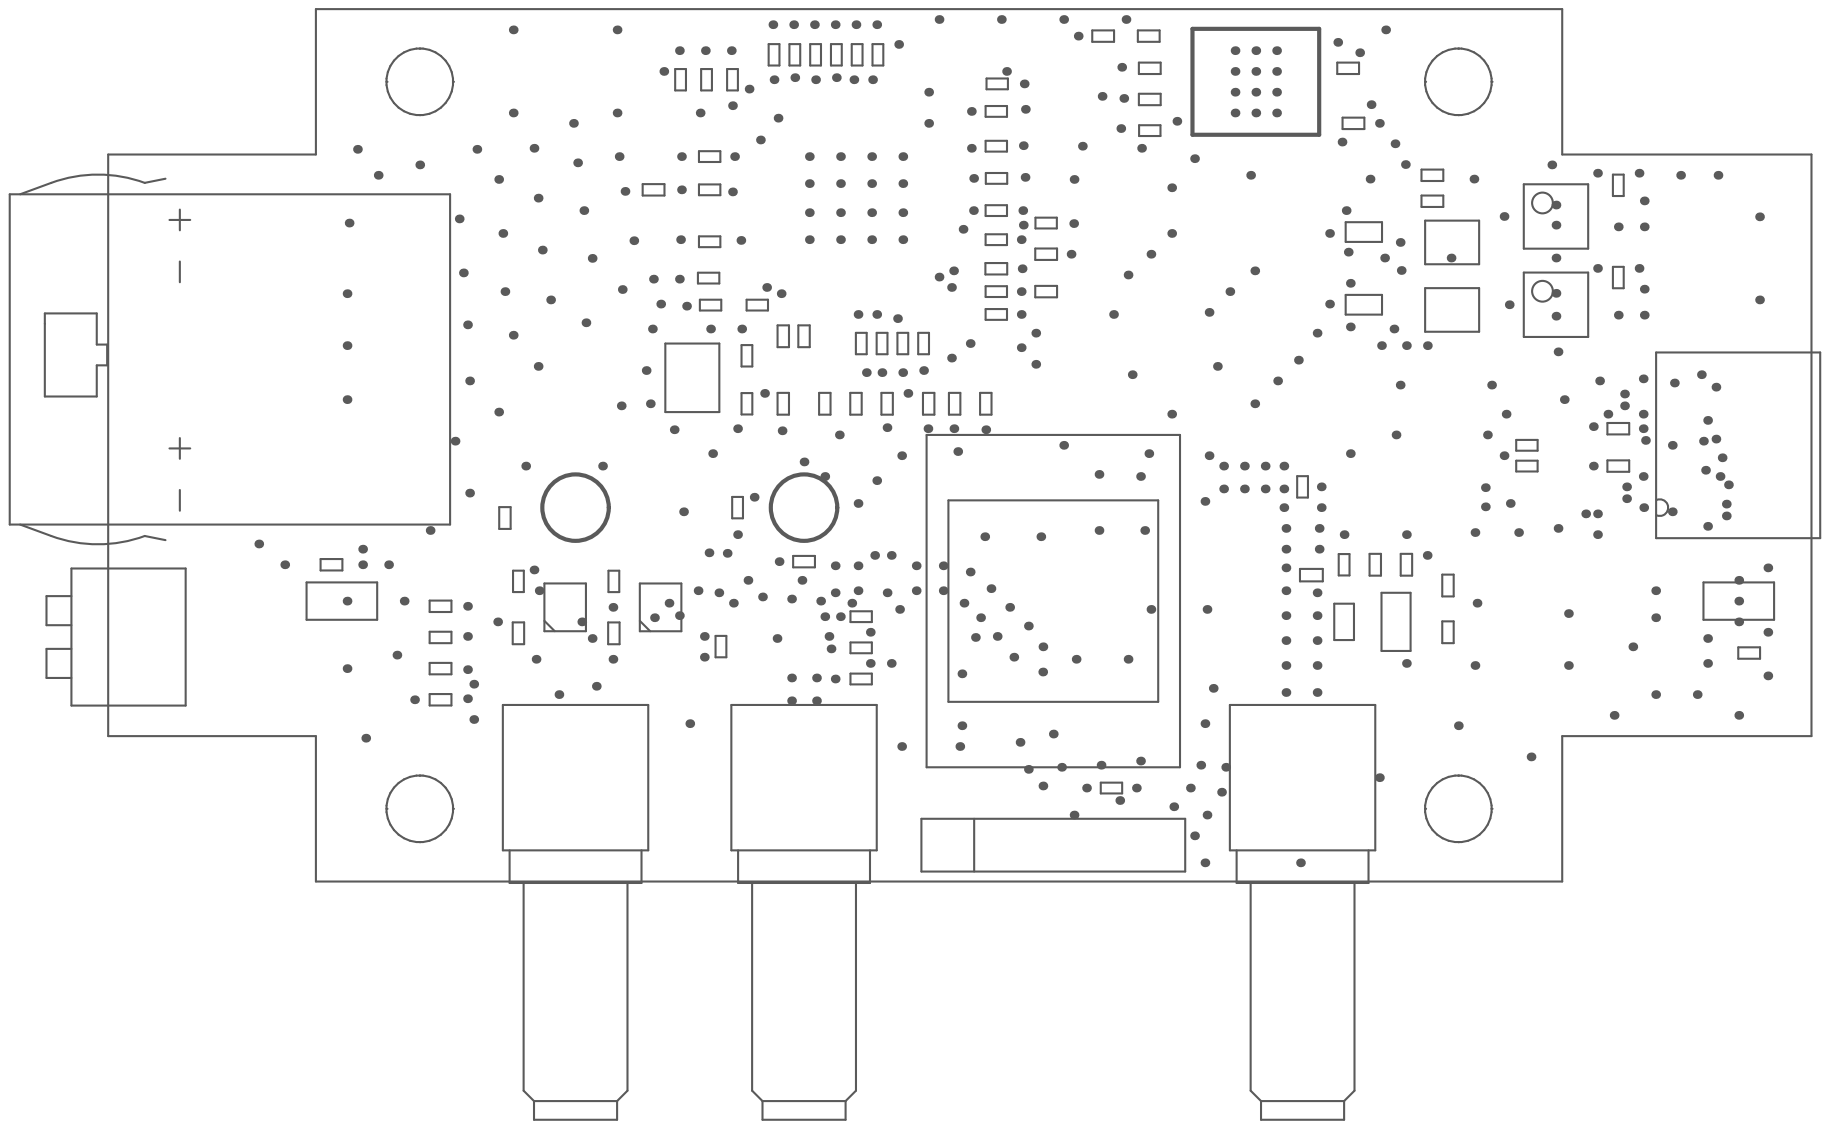
[picture p12: page 2]

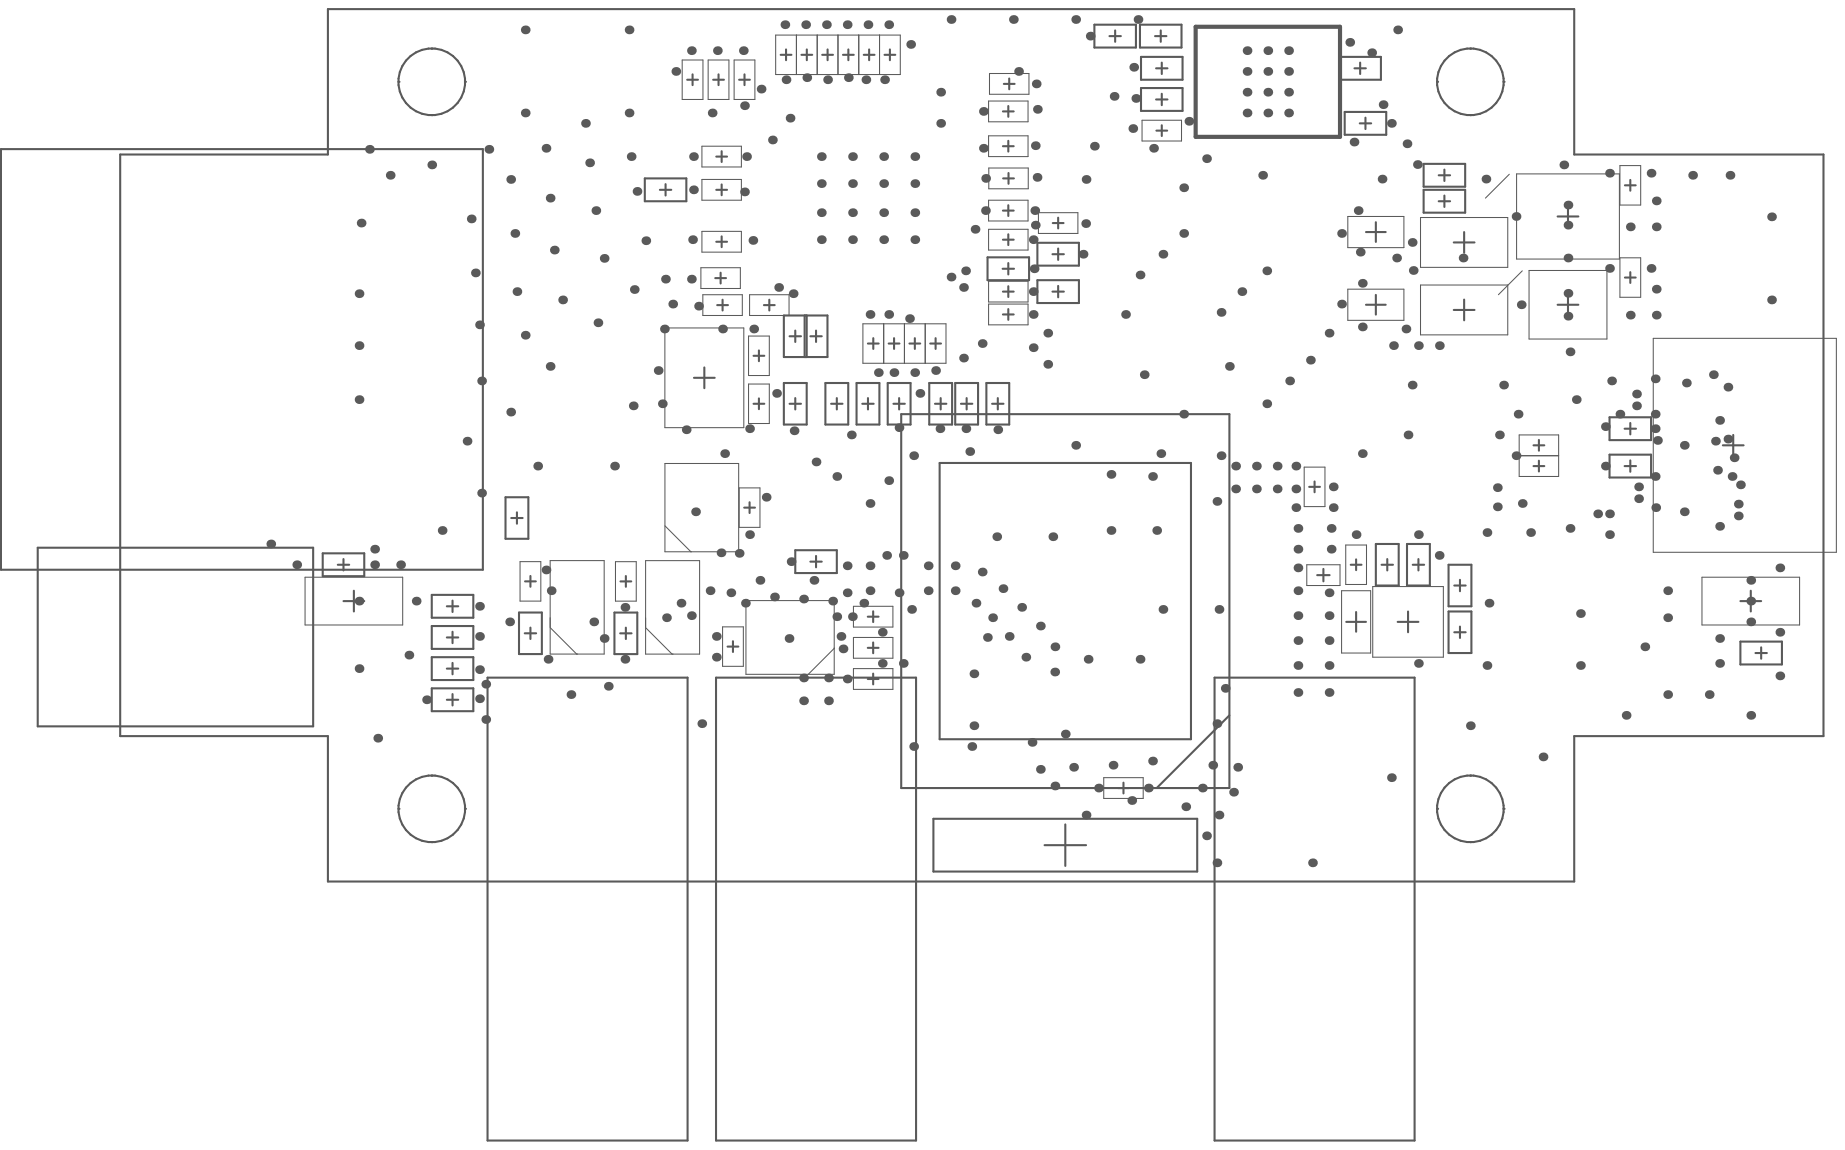
[picture p13: page 3]
