SiwaNetwork/QuantumStick/TimeStick2/ECAD/Project Outputs for TIMESTICK_2/TIMESTICK_2_release ASSEMBLY 2025-02-25 10-53.PDF

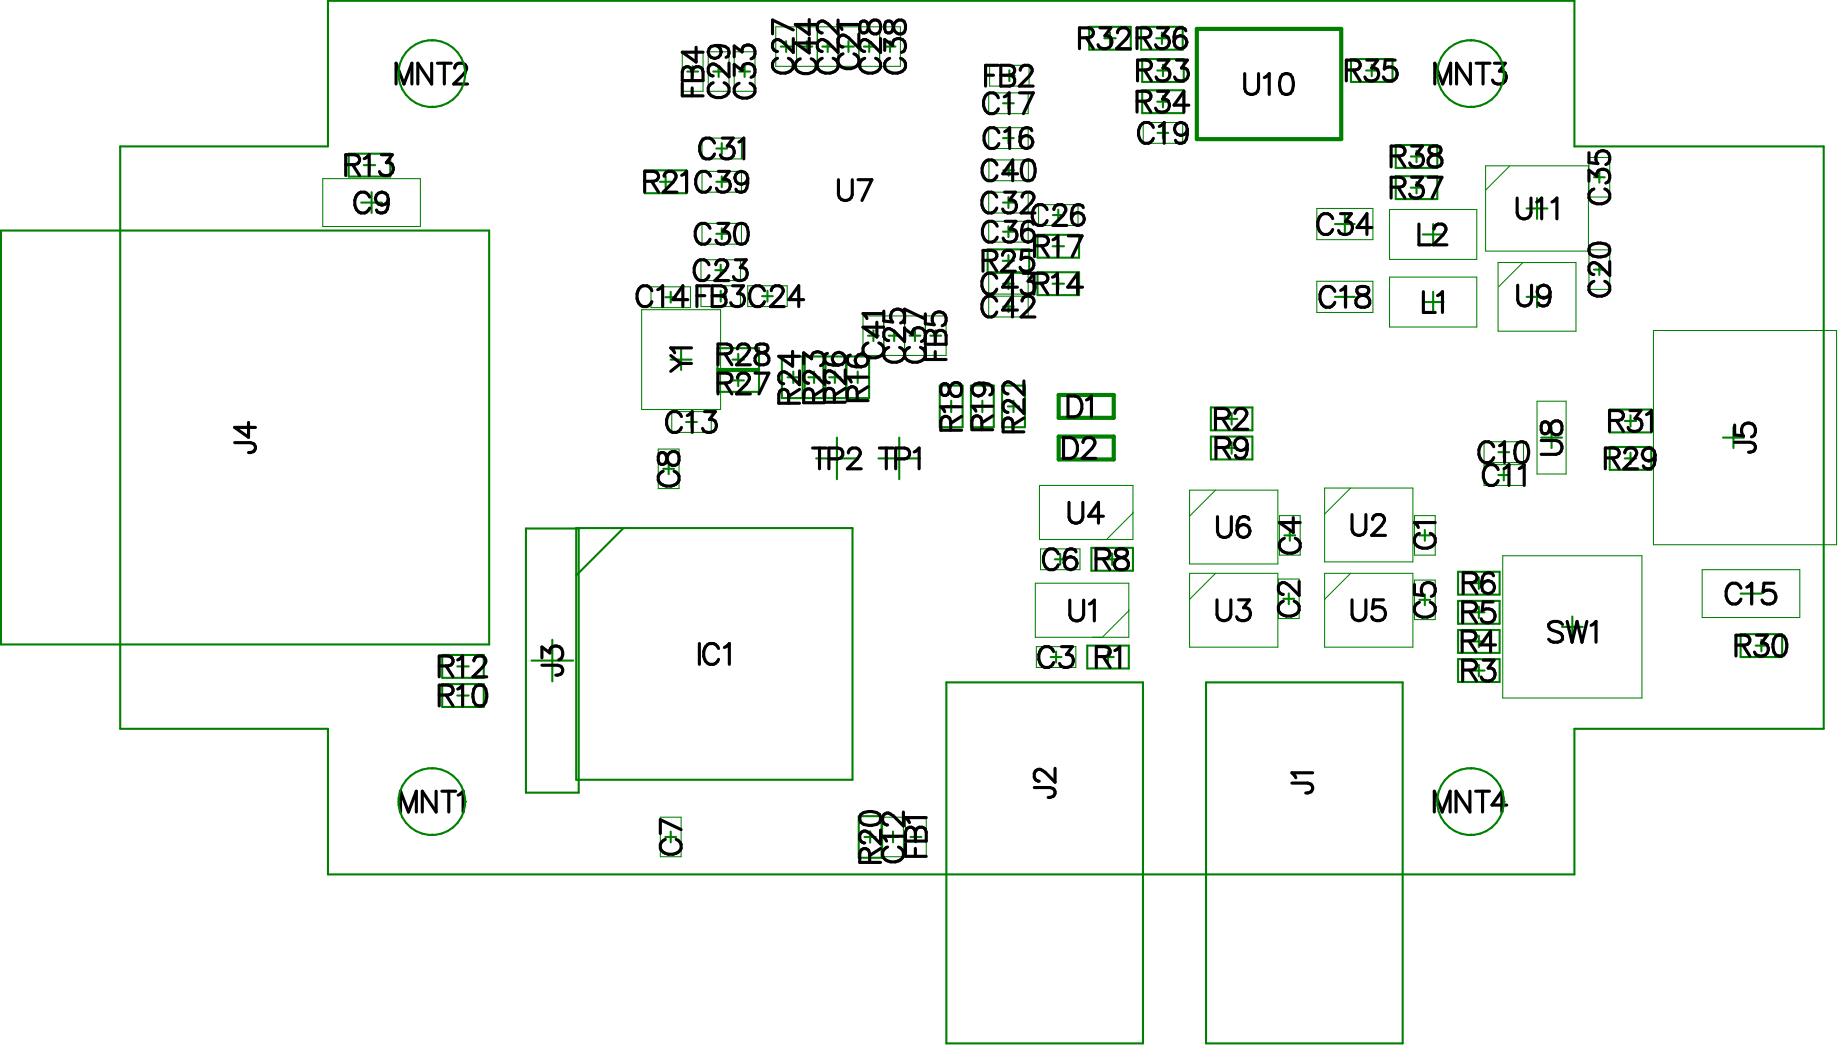
[picture p14: page 1]
