SiwaNetwork/QuantumStick/TimeStick2/Archive/Schematic Prints of Sheet1.SchDoc.PDF

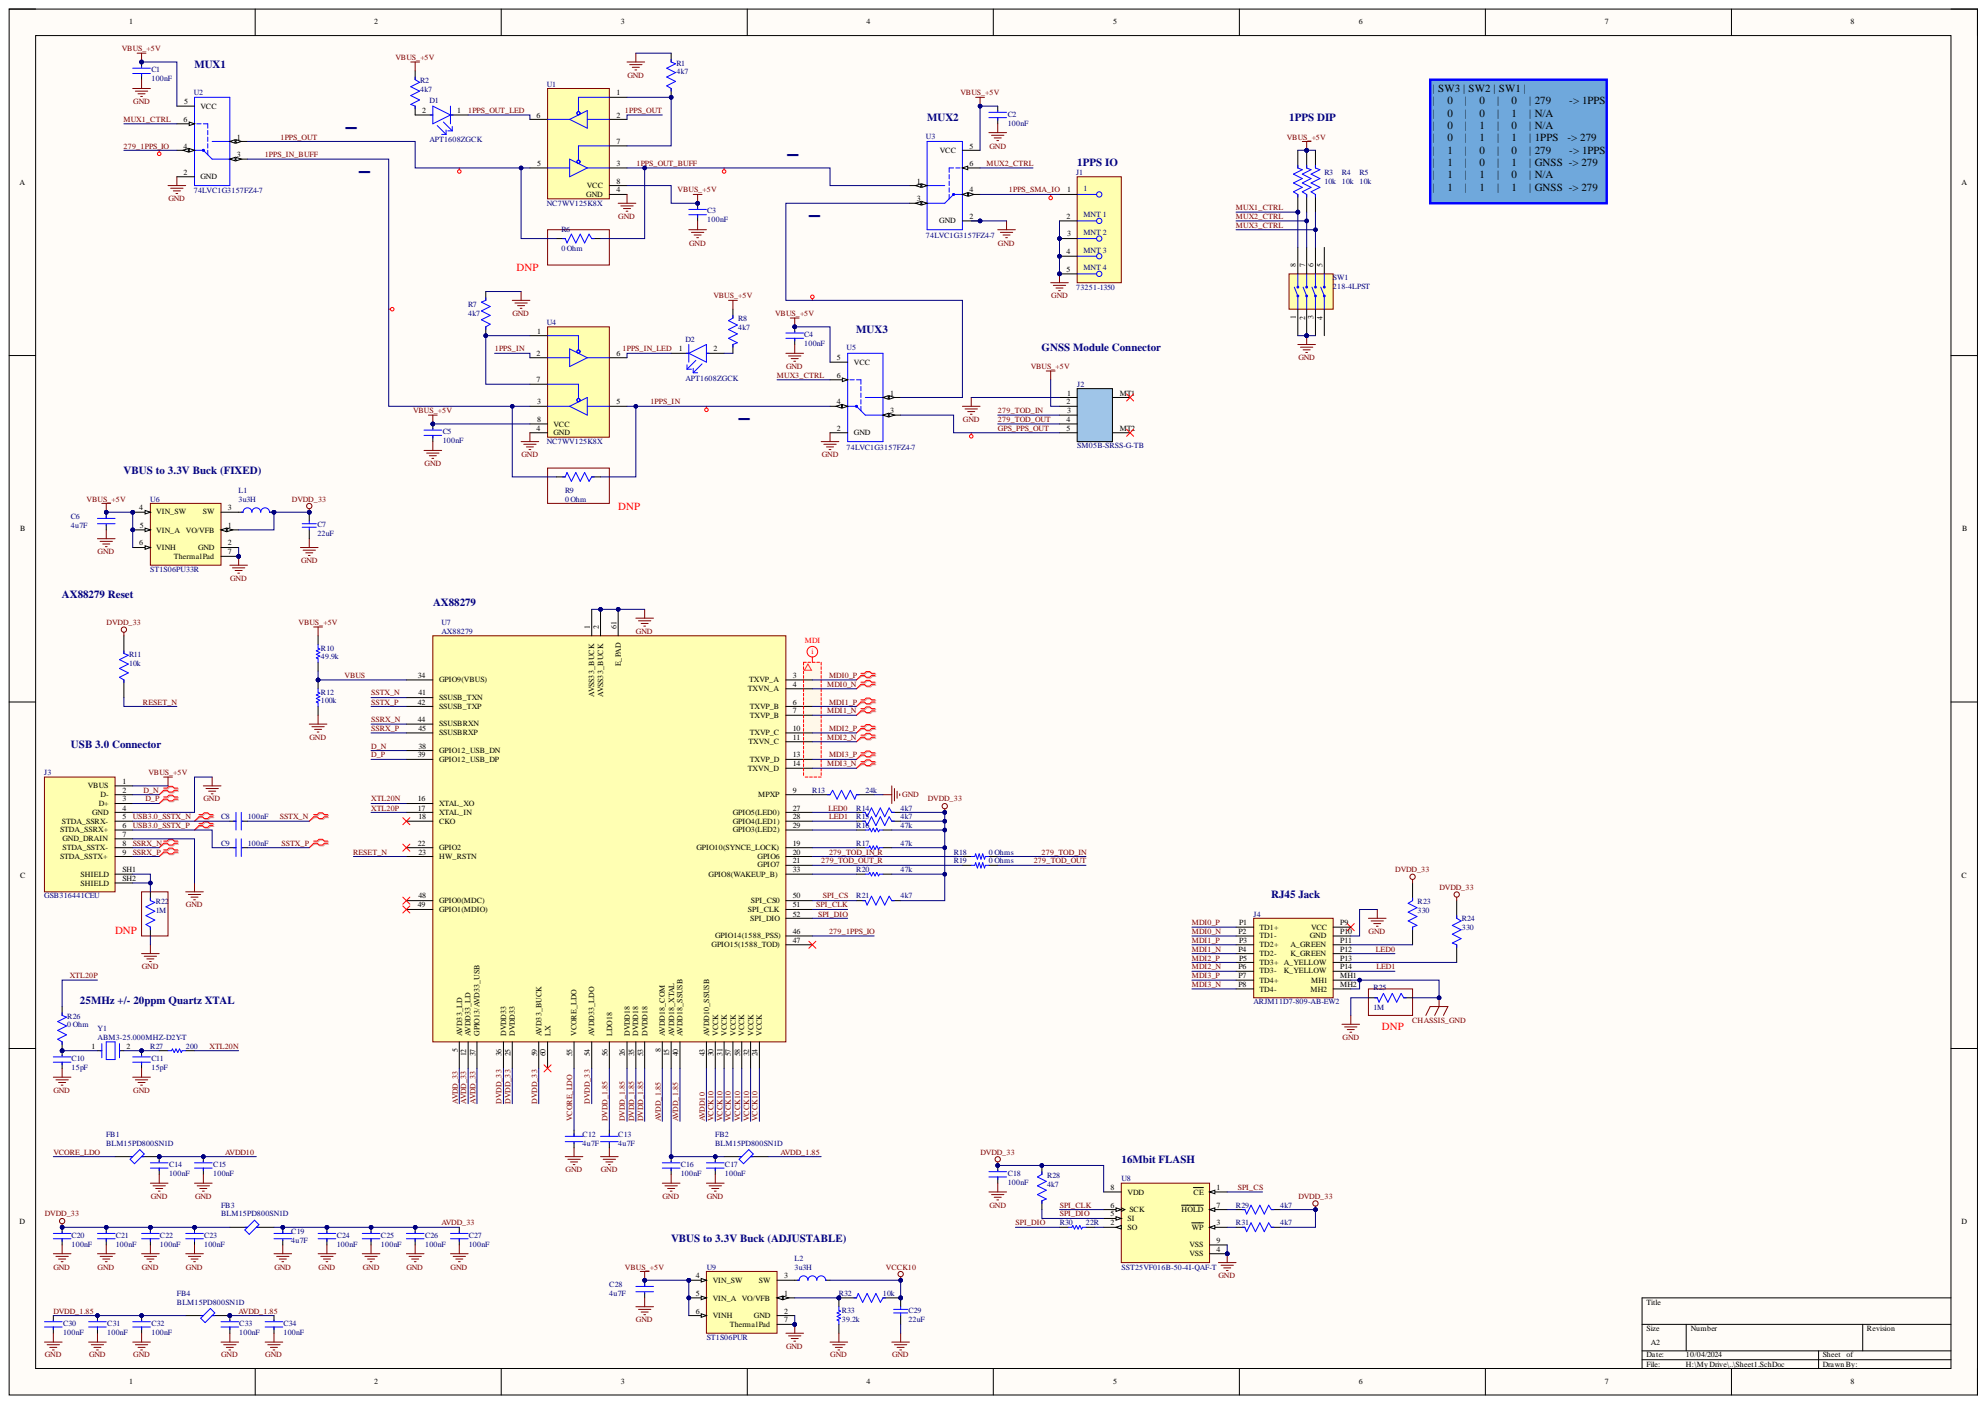
[picture p15: page 1]

VBUS to 3.3V Buck (FIXED)

279_TOD_OUT_R

VBUS to 3.3V Buck (ADJUSTABLE)
