SiwaNetwork/QuantumStick/(list of files, drawings)

Other design files:
TimeStick2.1.2/ECAD/MAIN.SchDoc
TimeStick2.1.2/ECAD/TIMESTICK_2.1.2.PrjPcb
TimeStick2.1.3/ECAD/MAIN.SchDoc
TimeStick2.1.3/ECAD/TIMESTICK_2.1.3.PrjPcb
TimeStick2/Archive/ECAD-10_04_2024/06_TIME_STICK_279.PrjPcb
TimeStick2/Archive/ECAD-10_04_2024/Sheet1.SchDoc
TimeStick2/ECAD/MAIN.SchDoc
TimeStick2/ECAD/TIMESTICK_2.1.1.PrjPcb
TimeStick/ECAD/02_PTP_USB_TO_RJ45_DRC/02_PTP_USB_TO_RJ45_DRC.PrjPcb
TimeStick/ECAD/02_PTP_USB_TO_RJ45_DRC/Sheet1.SchDoc
