SiwaNetwork/QuantumStick/(commit log)

2025-07-18 Add Russian translations of driver documentation and code comments
2025-07-18 Add kernel 6.11+ compatibility patch for TimeStick USB-Ethernet driver
2025-07-19 Create QuantumStick Web Monitor with real-time device monitoring interface
2025-07-20 Удалена вся поддержка Windows из драйвера и мониторинга
    - Удален весь каталог windows_driver/ с драйвером для Windows
    - Удален модуль windows_support.py из web_monitor/
    - Удалены Windows-специфичные импорты и код из app.py
    - Удалены Windows контролы и функции из HTML шаблона
    - Удалены Windows-специфичные пакеты из requirements.txt
    - Удалена документация WINDOWS_IMPLEMENTATION.md
    - Удалены Windows-связанные git ветки
    - Теперь поддерживается только Linux п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
2025-07-20 Добавлена сводка удаления поддержки Windows
    - Создан документ REMOVAL_SUMMARY.md с полным описанием изменений
    - Перечислены все удаленные файлы и директории
    - Описаны изменения в существующих файлах
    - Статистика: удалено ~20,000 строк Windows-специфичного кода
