SiwaNetwork/QuantumStick/(notices)

Notices in the files:
web_monitor/README.md:
License: GPL v2
